momysnow/Momy-Desk-Robot/README.md

<div align="center">
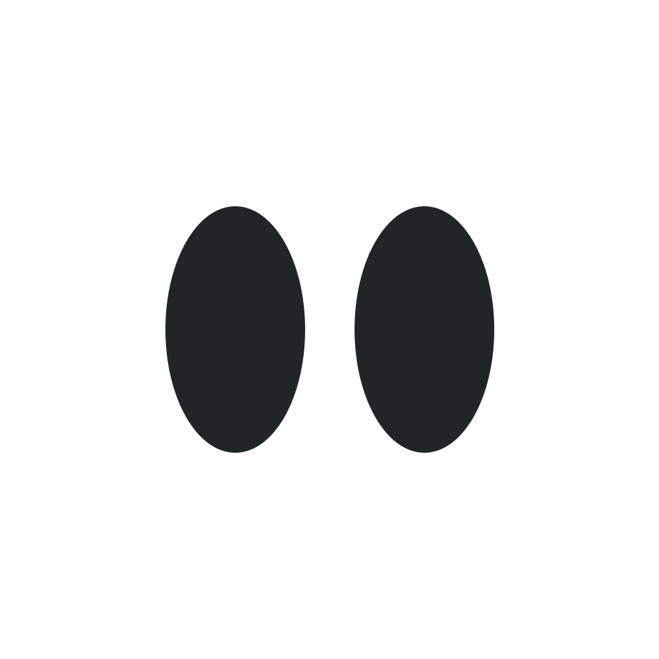
[picture p1: image/logo.png]
Momy logo
    
    <h1>Momy - Desk Robot</h1>
</div>

Welcome to the repository of the Momy project, a cutting-edge desk robot designed to provide a wide range of features that enhance human-machine interaction. Momy is equipped with advanced sensory and processing capabilities, making it an ideal companion for various daily activities.
<div align="center">
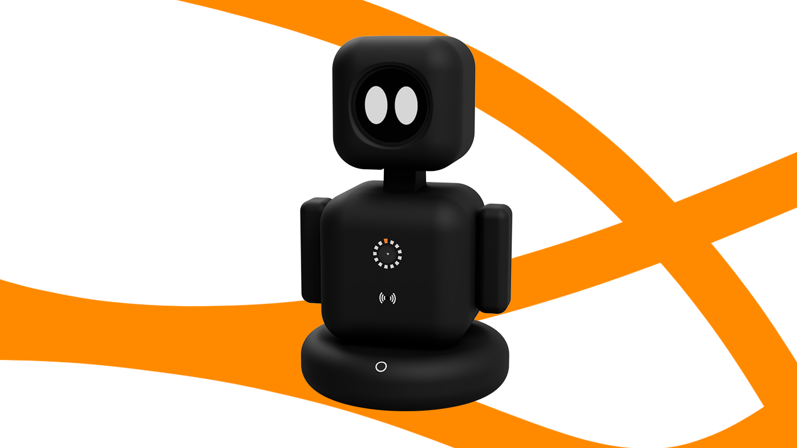
[picture p2: image/render_cubot_v5_sfondo.png]
Momy robot render
    
</div>

# Key Features
### 1. Advanced Vision
The integrated camera allows Momy to perceive and interpret the surrounding environment, opening the door to a range of applications, including facial recognition.

### 2. Active Listening
With the integrated microphone, Momy can listen and understand audio inputs. This feature not only enables vocal interaction with the robot but also opens the door to voice recognition applications.

### 3. Sound Response
The built-in speaker not only allows Momy to respond vocally but also provides the ability to produce a variety of sounds to enrich the interactive experience.

### 4. Visual Feedback
The built-in screen provides visual feedback to the user, allowing Momy to communicate effectively through text, graphics, and more.

### 5. Intelligent Mobility
Momy can move various parts of its body, ensuring a dynamic and interactive physical presence.

### 6. Environmental Monitoring
An integrated thermometer measures internal temperature and humidity, offering an additional dimension of environmental awareness and eliminating the possibility of damage caused by high temperatures or excessive humidity. In such cases, the robot enters protection mode and notifies the user of the issue.

### 7. Optimized Power System
Internal batteries enable Momy to operate wirelessly, with a recharge management module for added convenience.

### 8. Remote Control with ESP32S3
Using ESP32S3, Momy can be remotely controlled, browse the Internet, and handle complex tasks such as audio-to-text conversion.

<div align="center">
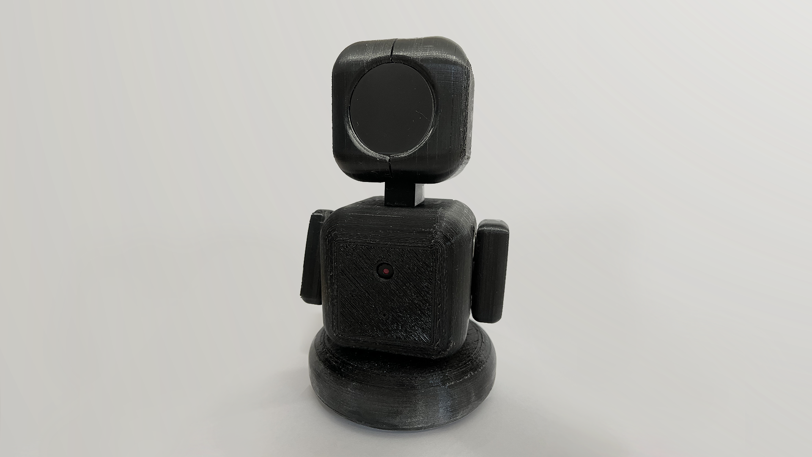
[picture p3: image/front_real.png]
Momy robot in reality
    
</div>

# Future Development Possibilities
The Momy project is open to further developments. Some possible extensions include integration with voice assistants like Alexa, sending camera images to a server for facial recognition, and many more.

# [Documentation and Instructions](https://github.com/momysnow/Momy-Desk-Robot/wiki)
For further details on configuration, installation, and use of Momy, refer to the Robot [Documentation](https://github.com/momysnow/Momy-Desk-Robot/wiki).

For detailed assembly and feature instructions, consult the Instruction Booklet(Coming Soon).

# [Discord Server](https://discord.gg/V63W7n23pe)
For easier communication and real-time updates on the project's progress, I have created a [Discord server](https://discord.gg/V63W7n23pe)!!

# Contributions
I'm excited to welcome contributions from the community! If you have ideas, suggestions, or wish to contribute to the development of Momy, feel free to join the community and propose your changes.

Thank you for exploring the Momy project with me. I'm excited to see how this versatile platform can enrich your daily experience!

I hope this presentation meets your needs. Feel free to customize it further based on the specific features and goals of your project.

# Copyright
<p xmlns:cc="http://creativecommons.org/ns#" xmlns:dct="http://purl.org/dc/terms/">All the files in <a property="dct:title" rel="cc:attributionURL" href="https://github.com/momysnow/Momy-Desk-Robot">Momy-Desk-Robot</a> by <a rel="cc:attributionURL dct:creator" property="cc:attributionName" href="https://github.com/momysnow">momysnow</a> is licensed under <a href="http://creativecommons.org/licenses/by-nc-sa/4.0/?ref=chooser-v1" target="_blank" rel="license noopener noreferrer" style="display:inline-block;">Attribution-NonCommercial-ShareAlike 4.0 International</a></p>
You can find a copy of the license in this repository.
