momysnow/Momy-Desk-Robot/image/components_img/Electronic/24-pin_0.5mm_FFC_FPC_Extender.jpg

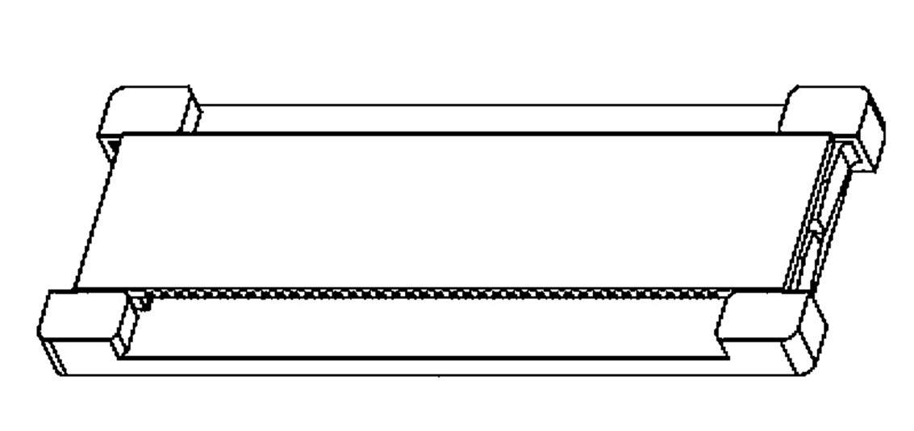
image/components_img/Electronic/24-pin_0.5mm_FFC_FPC_Extender.jpg
