momysnow/Momy-Desk-Robot/image/components_img/Electronic/DHT11.png

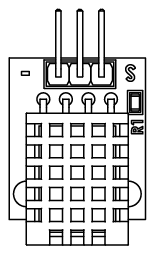
image/components_img/Electronic/DHT11.png
