momysnow/Momy-Desk-Robot/image/components_img/Electronic/Freenove_ESP32_S3_WROOM_Board.png

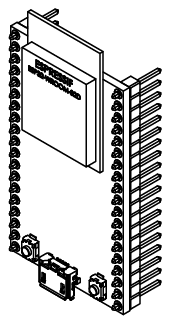
image/components_img/Electronic/Freenove_ESP32_S3_WROOM_Board.png
