momysnow/Momy-Desk-Robot/image/components_img/Electronic/inmp441.png

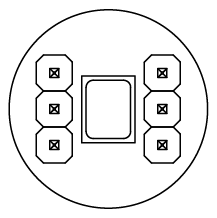
image/components_img/Electronic/inmp441.png
