momysnow/Momy-Desk-Robot/image/components_img/Electronic/Li-ion_18650.png

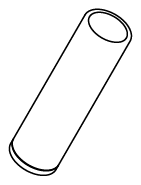
image/components_img/Electronic/Li-ion_18650.png
