momysnow/Momy-Desk-Robot/image/components_img/Electronic/MAX98357A.png

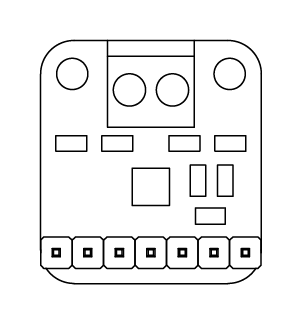
image/components_img/Electronic/MAX98357A.png
