momysnow/Momy-Desk-Robot/image/components_img/Electronic/ov2640.png

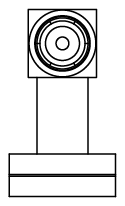
image/components_img/Electronic/ov2640.png
