momysnow/Momy-Desk-Robot/image/components_img/Electronic/Round_LCD_Display.png

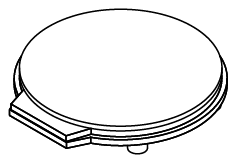
image/components_img/Electronic/Round_LCD_Display.png
