momysnow/Momy-Desk-Robot/image/components_img/Electronic/sg90-analog-9g.png

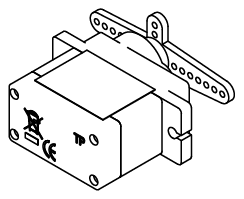
image/components_img/Electronic/sg90-analog-9g.png
