momysnow/Momy-Desk-Robot/image/components_img/Electronic/TP4056.png

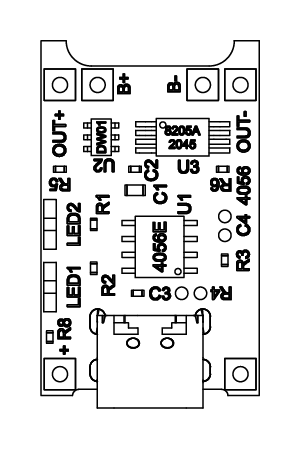
image/components_img/Electronic/TP4056.png
