momysnow/Momy-Desk-Robot/image/Momy.png

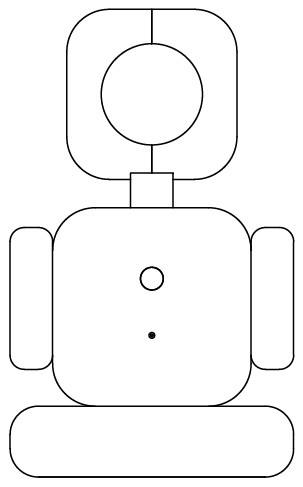
image/Momy.png
