momysnow/Momy-Desk-Robot/image/components_img/Physical/arm_L.jpg

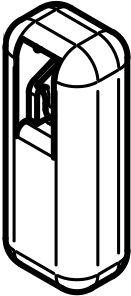
image/components_img/Physical/arm_L.jpg
