momysnow/Momy-Desk-Robot/image/components_img/Physical/arm_R.jpg

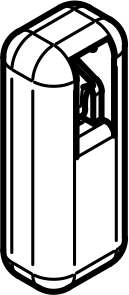
image/components_img/Physical/arm_R.jpg
