momysnow/Momy-Desk-Robot/image/components_img/Physical/back_body.jpg

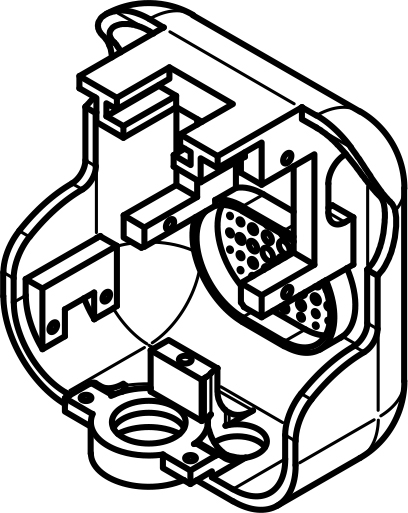
image/components_img/Physical/back_body.jpg
