momysnow/Momy-Desk-Robot/image/components_img/Physical/base.png

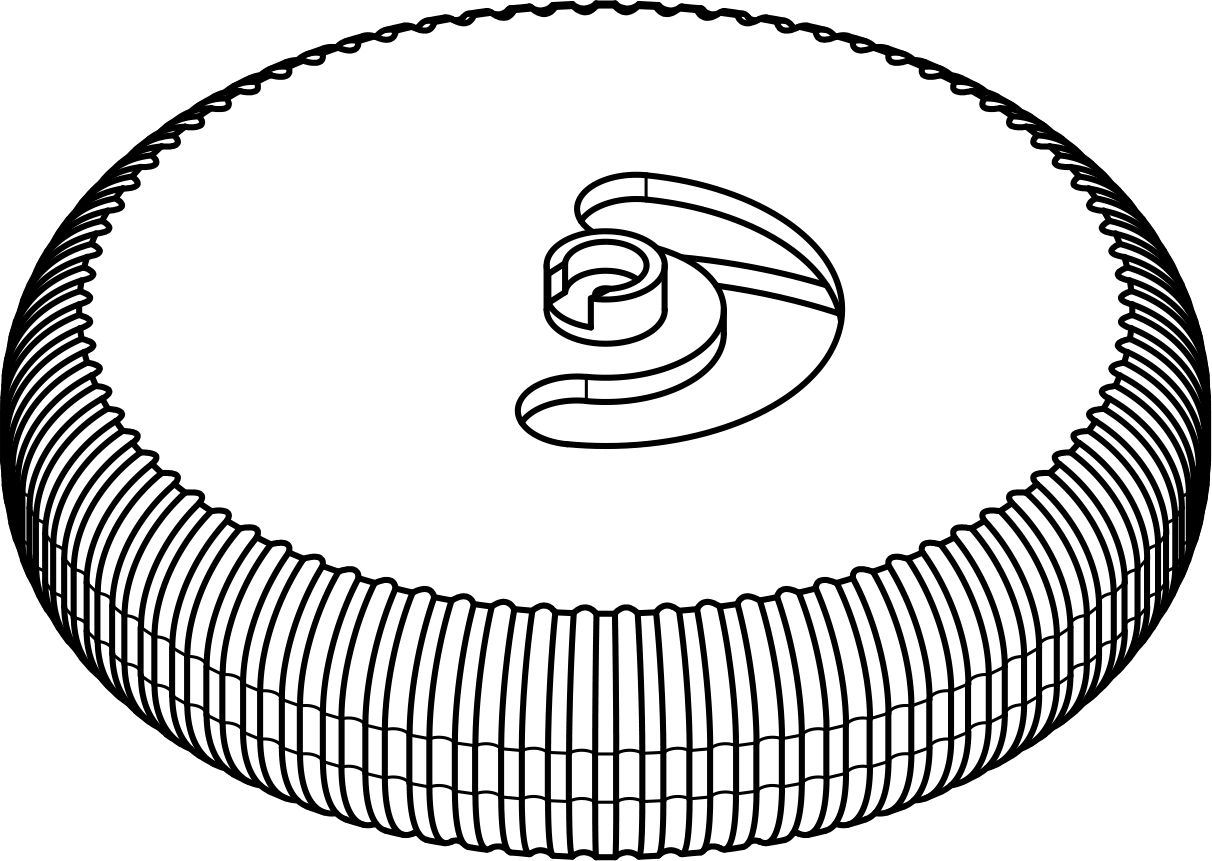
image/components_img/Physical/base.png
