momysnow/Momy-Desk-Robot/image/components_img/Physical/base_Rubber.jpg

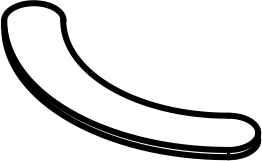
image/components_img/Physical/base_Rubber.jpg
