momysnow/Momy-Desk-Robot/image/components_img/Physical/bearing.png

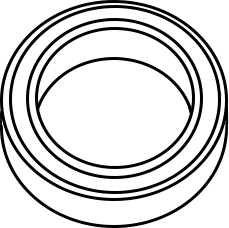
image/components_img/Physical/bearing.png
