momysnow/Momy-Desk-Robot/image/components_img/Physical/cover_base.jpg

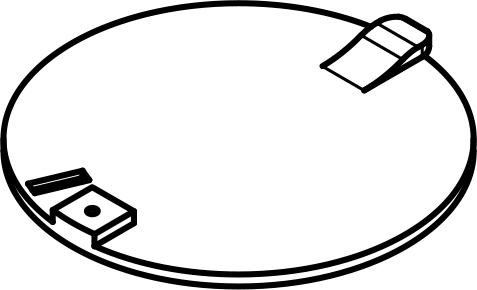
image/components_img/Physical/cover_base.jpg
