momysnow/Momy-Desk-Robot/image/components_img/Physical/front_body.jpg

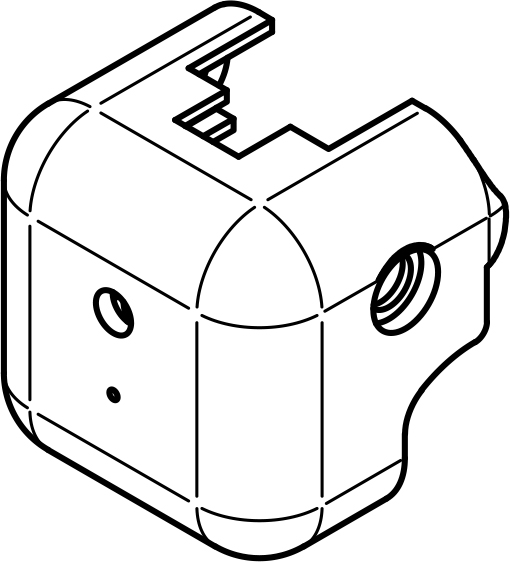
image/components_img/Physical/front_body.jpg
