momysnow/Momy-Desk-Robot/image/components_img/Physical/gear.png

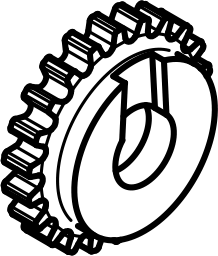
image/components_img/Physical/gear.png
