momysnow/Momy-Desk-Robot/image/components_img/Physical/head_L.jpg

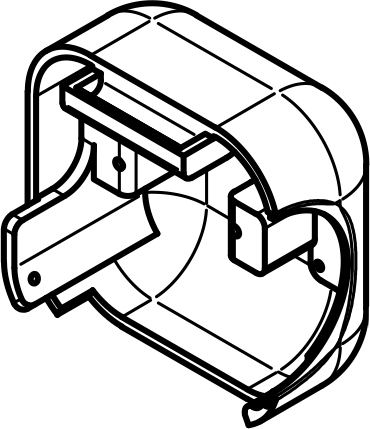
image/components_img/Physical/head_L.jpg
