momysnow/Momy-Desk-Robot/image/components_img/Physical/head_R.jpg

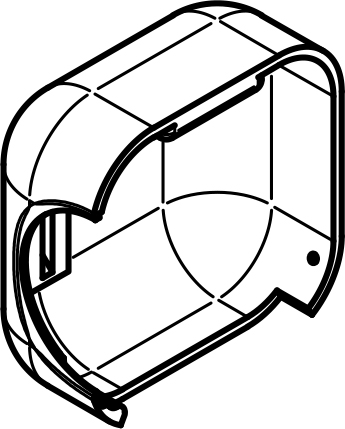
image/components_img/Physical/head_R.jpg
