momysnow/Momy-Desk-Robot/image/components_img/Physical/neck.png

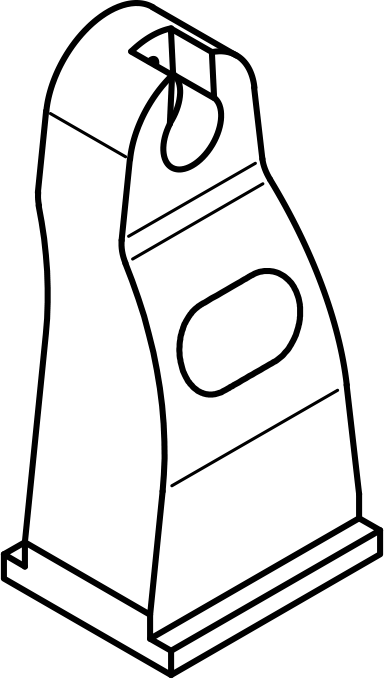
image/components_img/Physical/neck.png
