momysnow/Momy-Desk-Robot/image/components_img/Physical/original_screw_m2x8.png

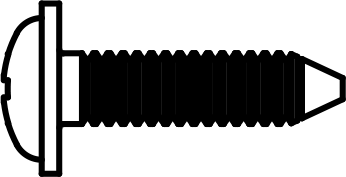
image/components_img/Physical/original_screw_m2x8.png
