momysnow/Momy-Desk-Robot/image/components_img/Physical/push_pin_L.png

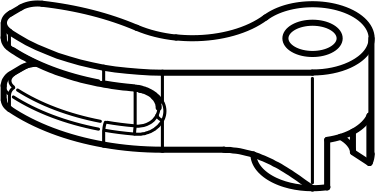
image/components_img/Physical/push_pin_L.png
