momysnow/Momy-Desk-Robot/image/components_img/Physical/push_pin_R.png

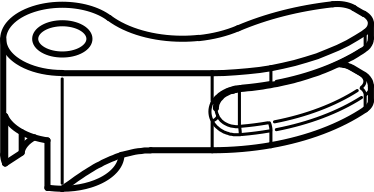
image/components_img/Physical/push_pin_R.png
