momysnow/Momy-Desk-Robot/image/components_img/Physical/rotate_arm.png

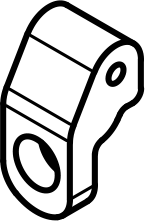
image/components_img/Physical/rotate_arm.png
