momysnow/Momy-Desk-Robot/image/components_img/Physical/rotate_gear.png

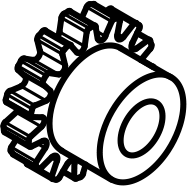
image/components_img/Physical/rotate_gear.png
