momysnow/Momy-Desk-Robot/image/components_img/Physical/screw.png

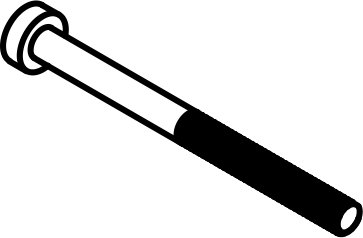
image/components_img/Physical/screw.png
