momysnow/Momy-Desk-Robot/image/components_img/Physical/screw_m2x4.png

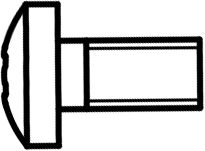
image/components_img/Physical/screw_m2x4.png
