momysnow/Momy-Desk-Robot/image/components_img/Physical/screw_m2x6.png

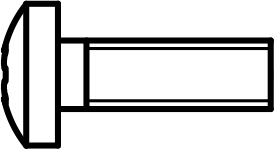
image/components_img/Physical/screw_m2x6.png
