momysnow/Momy-Desk-Robot/image/components_img/Physical/screw_m2x10.png

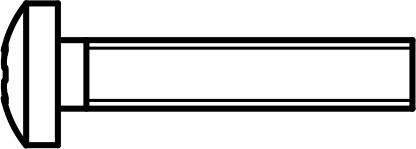
image/components_img/Physical/screw_m2x10.png
