momysnow/Momy-Desk-Robot/image/components_img/Physical/screw_m3x36.png

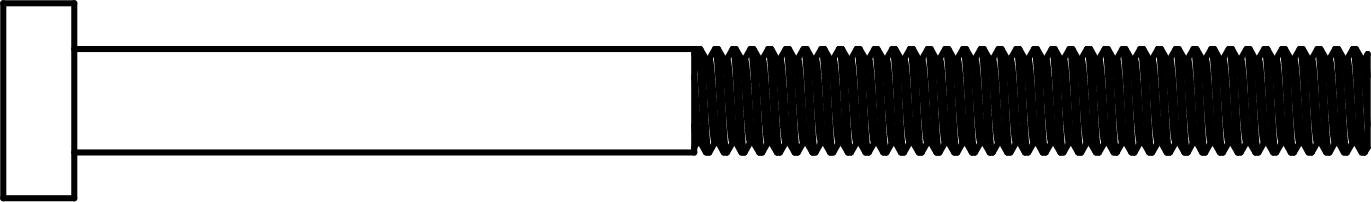
image/components_img/Physical/screw_m3x36.png
