momysnow/Momy-Desk-Robot/image/components_img/Physical/support.jpg

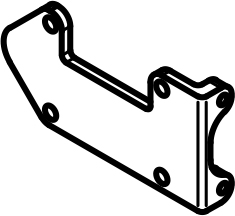
image/components_img/Physical/support.jpg
