momysnow/Momy-Desk-Robot/components/base/Base_Cap.stl

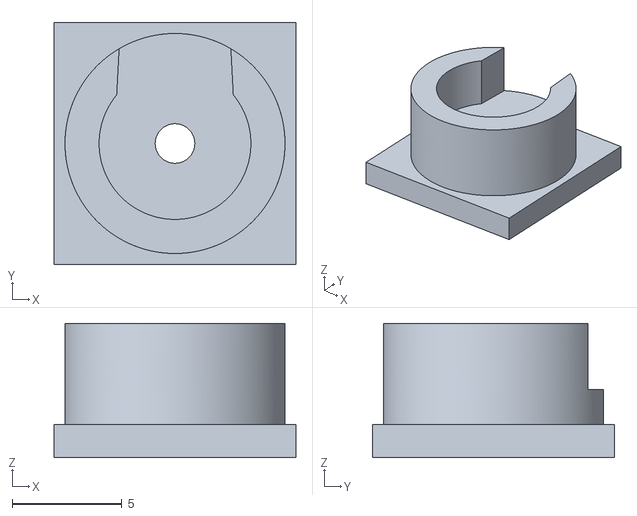
[picture p39: CAD file, 2024-02-13]
components/base/Base_Cap.stl
11.0 x 11.0 x 6.10
