momysnow/Momy-Desk-Robot/components/body/Body_Gear_Rotate_x2.stl

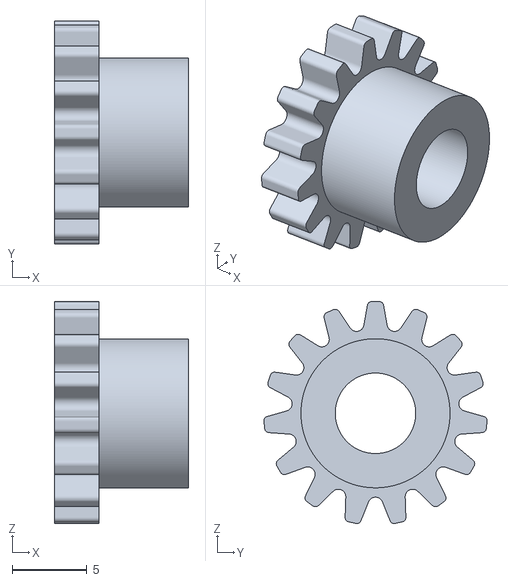
[picture p40: CAD file, 2024-02-10]
components/body/Body_Gear_Rotate_x2.stl
9.00 x 15.0 x 14.9
