momysnow/Momy-Desk-Robot/components/head/Head_Left.stl

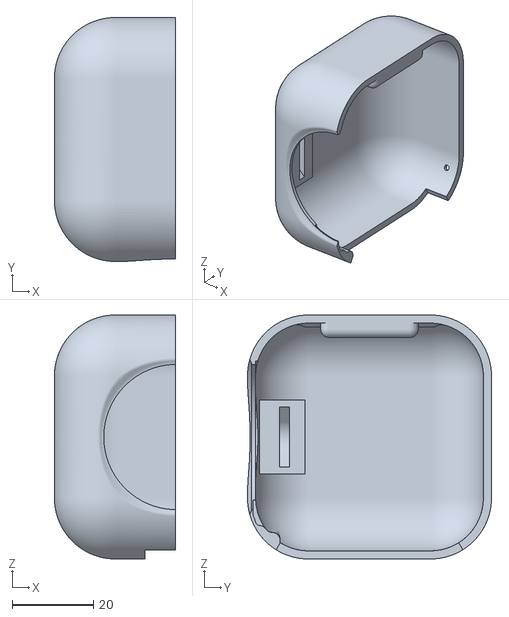
[picture p41: CAD file, 2024-02-10]
components/head/Head_Left.stl
29.8 x 60.0 x 60.0
