momysnow/Momy-Desk-Robot/components/Neck.stl

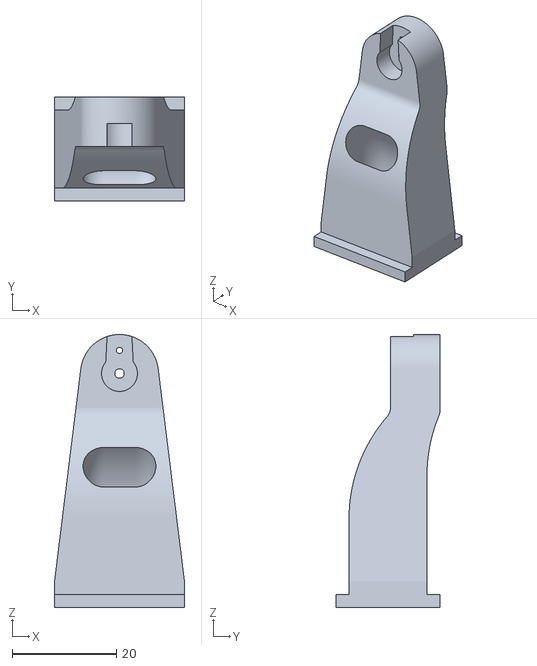
[picture p42: CAD file, 2024-02-10]
components/Neck.stl
25.0 x 20.0 x 52.5
