momysnow/Momy-Desk-Robot/components/base/Base_Bottom.stl

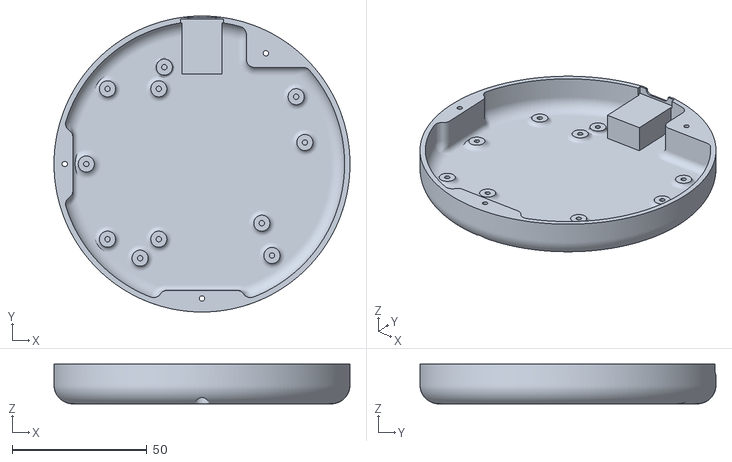
[picture p43: CAD file, 2024-02-13]
components/base/Base_Bottom.stl
110.0 x 110.0 x 14.8
