momysnow/Momy-Desk-Robot/components/body/Body_Gear_x2.stl

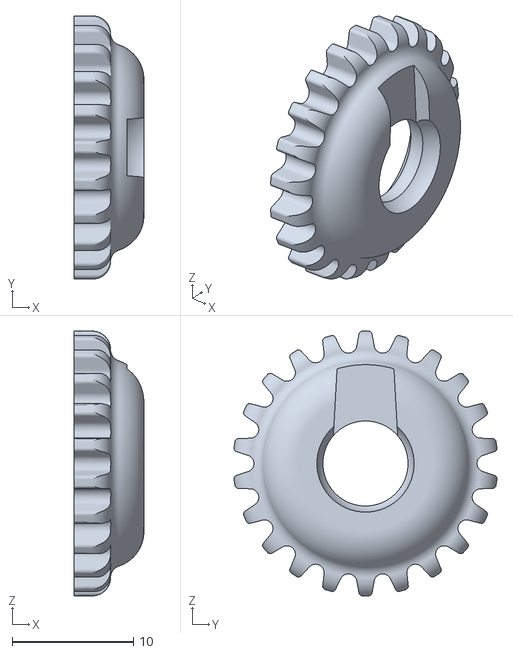
[picture p44: CAD file, 2024-02-10]
components/body/Body_Gear_x2.stl
5.75 x 21.7 x 21.8
