momysnow/Momy-Desk-Robot/components/head/Head_Right.stl

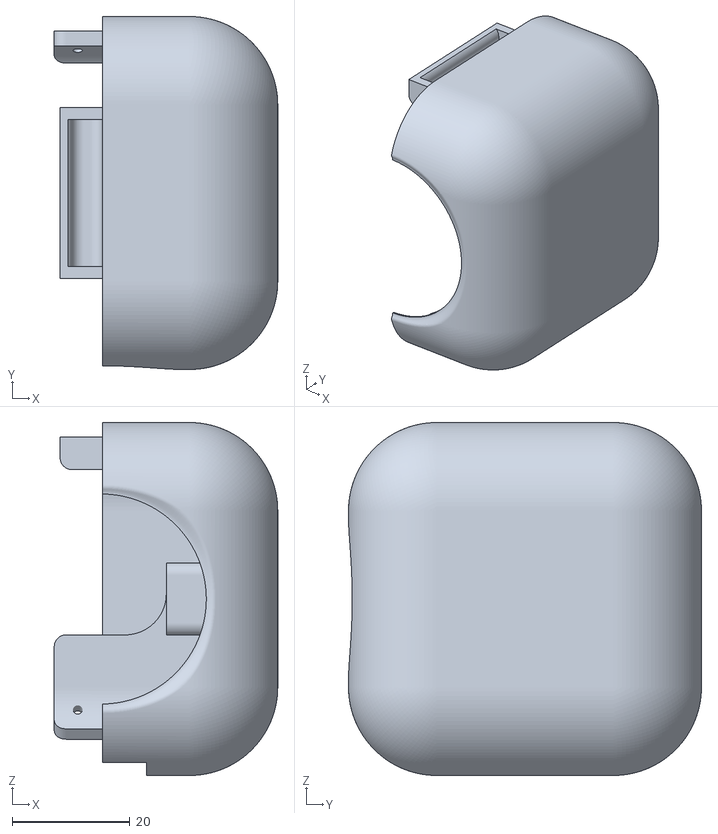
[picture p45: CAD file, 2024-02-10]
components/head/Head_Right.stl
38.0 x 60.0 x 60.0
