momysnow/Momy-Desk-Robot/components/body/Body_Rear.stl

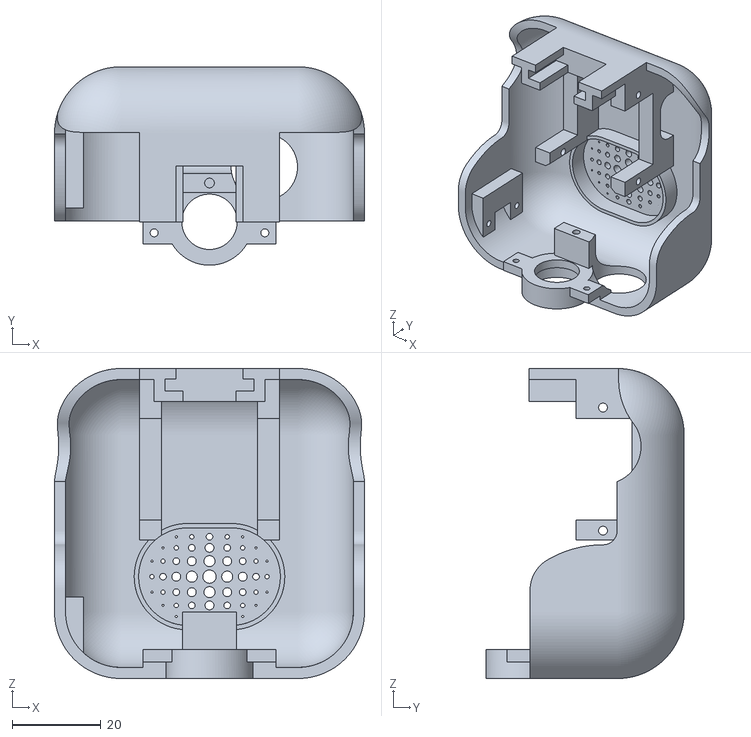
[picture p47: CAD file, 2024-02-04]
components/body/Body_Rear.stl
70.0 x 44.8 x 70.0
