momysnow/Momy-Desk-Robot/components/head/Head_Support.stl

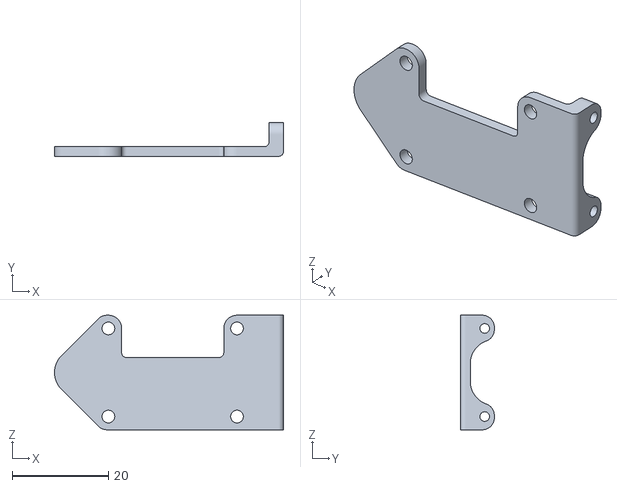
[picture p48: CAD file, 2024-02-04]
components/head/Head_Support.stl
47.5 x 7.00 x 23.8
