momysnow/Momy-Desk-Robot/components/base/Base_Rubber_Pad_x2.stl

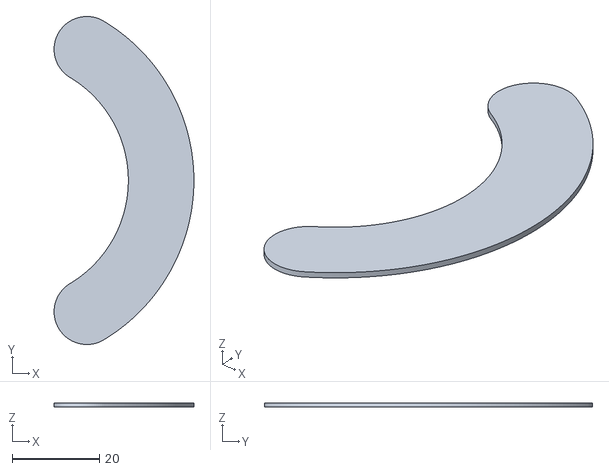
[picture p49: CAD file, 2024-02-04]
components/base/Base_Rubber_Pad_x2.stl
32.0 x 75.0 x 1.00
