momysnow/Momy-Desk-Robot/components/body/Body_Rotate_Arm_x2.stl

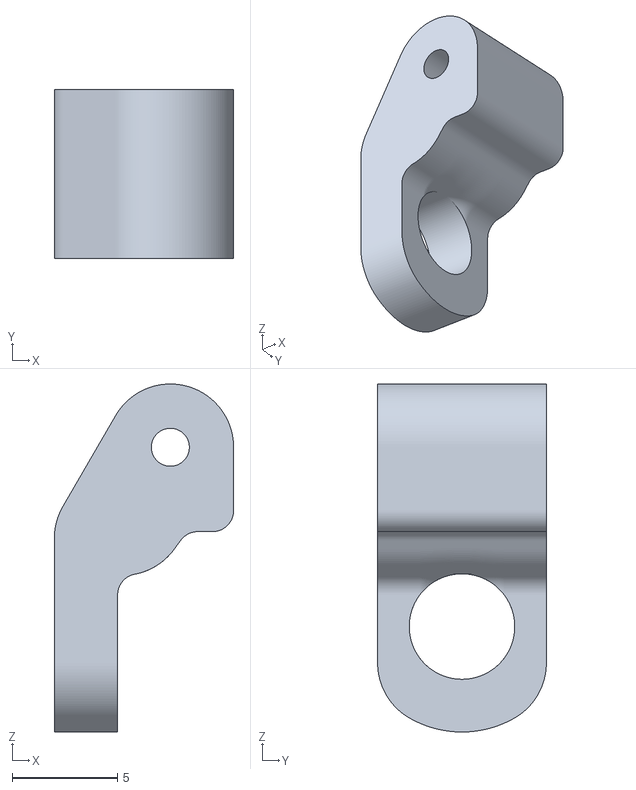
[picture p50: CAD file, 2024-02-04]
components/body/Body_Rotate_Arm_x2.stl
8.50 x 8.00 x 16.5
