momysnow/Momy-Desk-Robot/components/body/Body_Arm_Right.stl

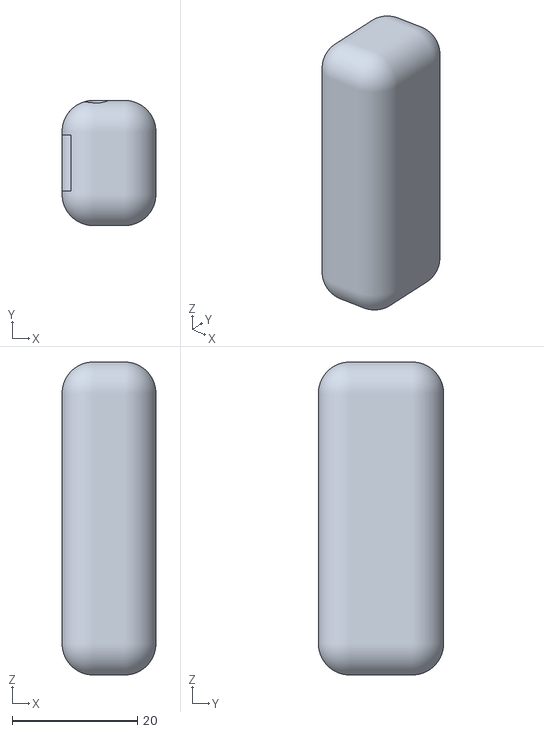
[picture p51: CAD file, 2024-02-04]
components/body/Body_Arm_Right.stl
15.0 x 20.0 x 50.0
