momysnow/Momy-Desk-Robot/components/body/Body_Ball_x2.stl

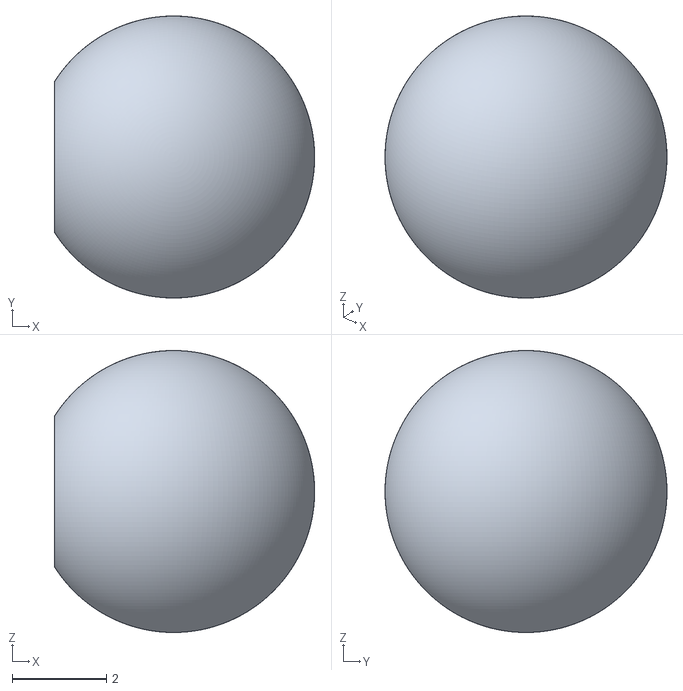
[picture p52: CAD file, 2024-02-04]
components/body/Body_Ball_x2.stl
5.54 x 6.00 x 6.00
