momysnow/Momy-Desk-Robot/components/body/Body_Push_Pin_Left.stl

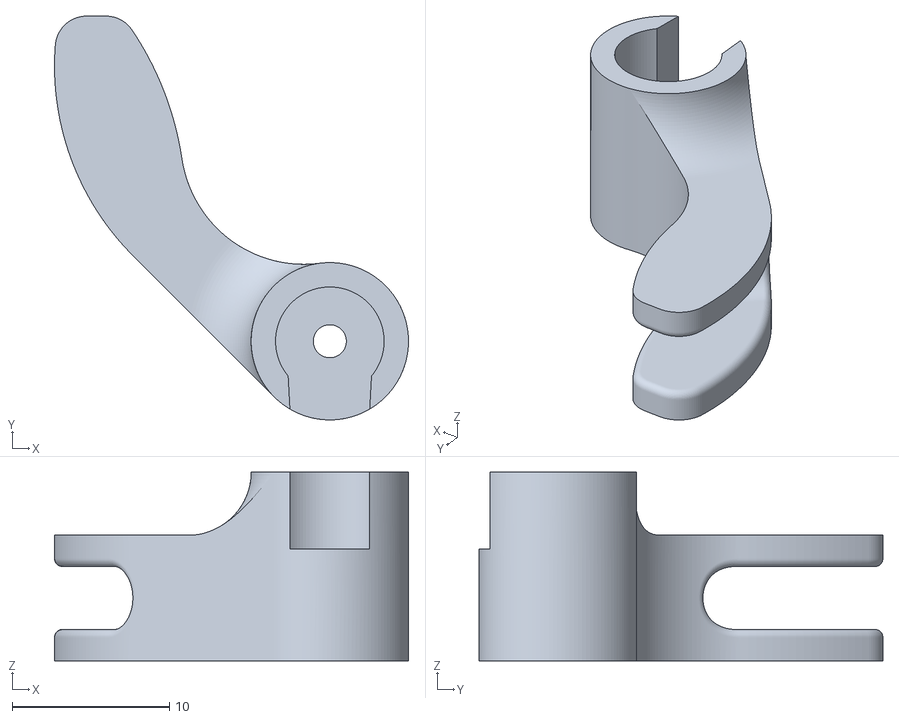
[picture p53: CAD file, 2024-02-04]
components/body/Body_Push_Pin_Left.stl
22.5 x 25.7 x 12.0
