momysnow/Momy-Desk-Robot/components/body/Body_Arm_Tube_x2.stl

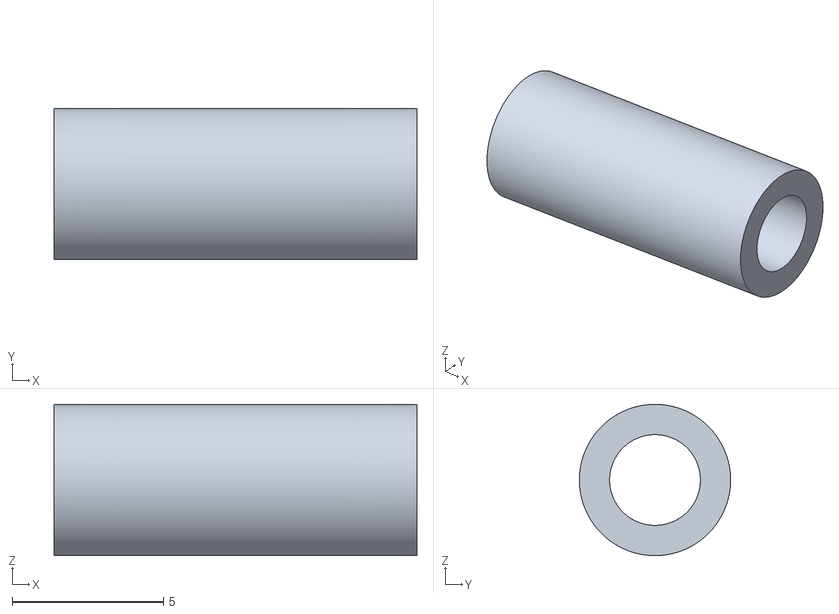
[picture p54: CAD file, 2024-02-04]
components/body/Body_Arm_Tube_x2.stl
12.0 x 5.00 x 5.00
