momysnow/Momy-Desk-Robot/components/body/Body_Anterior.stl

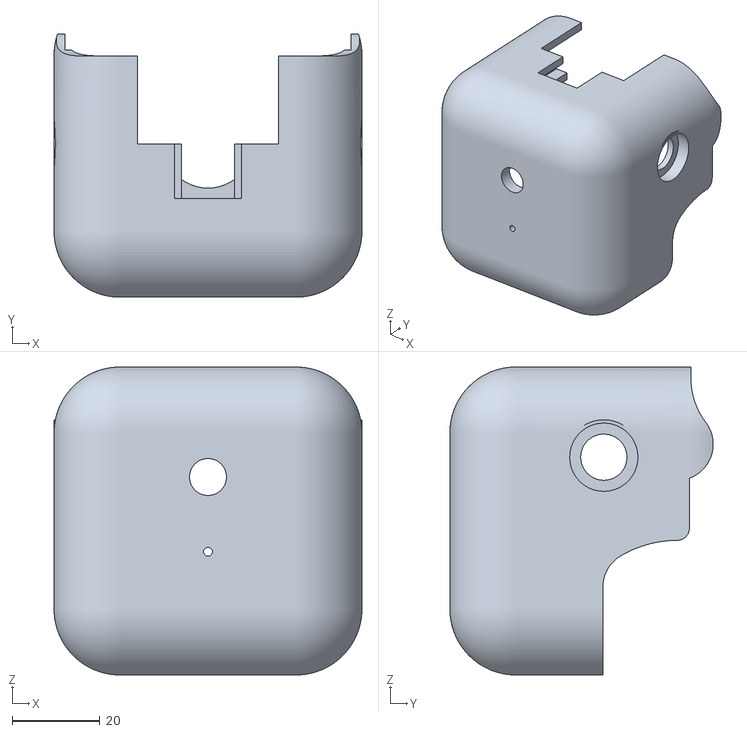
[picture p55: CAD file, 2024-02-04]
components/body/Body_Anterior.stl
70.0 x 59.9 x 70.0
