momysnow/Momy-Desk-Robot/(list of files, cad)

Other CAD files:
components/body/Body_Arm_Left.stl
components/body/Body_Push_Pin_Right.stl
components/body/Body_Closing_Screw_x2.stl
