momysnow/Momy-Desk-Robot/image/tutorial/arm.jpg

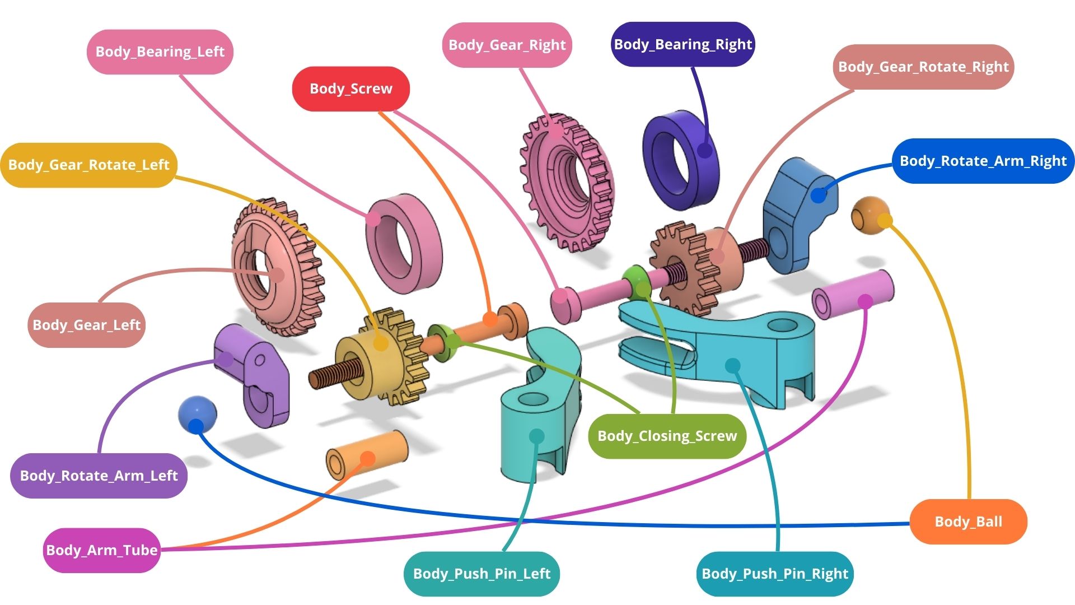
image/tutorial/arm.jpg
