momysnow/Momy-Desk-Robot/image/tutorial/base.jpg

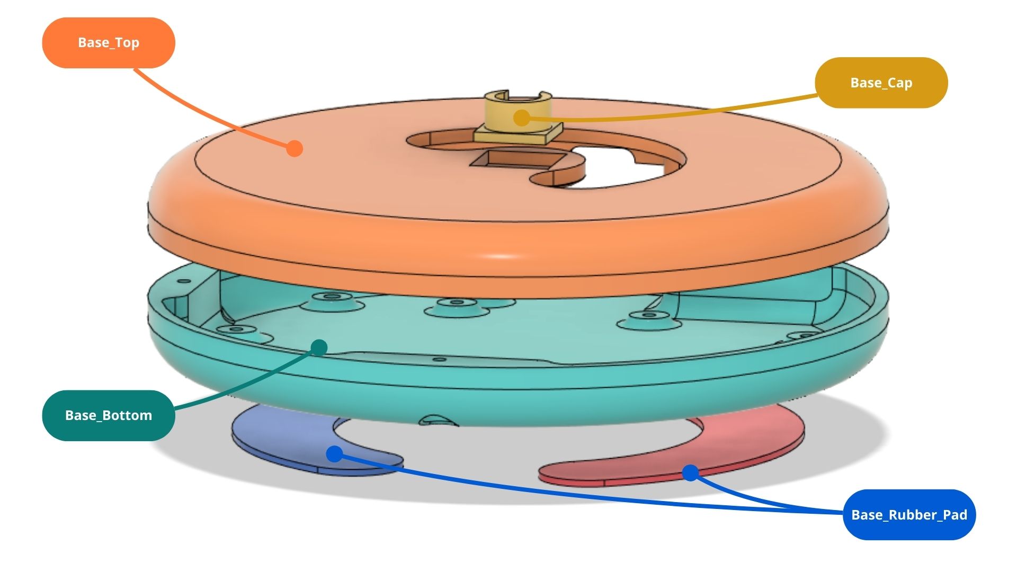
image/tutorial/base.jpg
