momysnow/Momy-Desk-Robot/image/tutorial/body.jpg

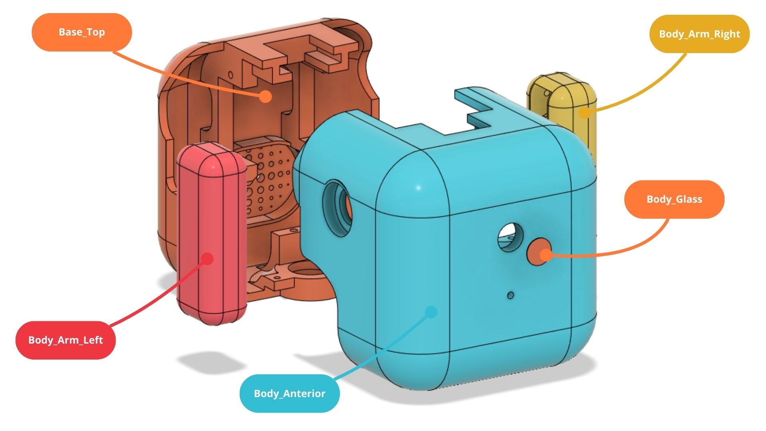
image/tutorial/body.jpg
