momysnow/Momy-Desk-Robot/image/tutorial/correct_screen.jpg

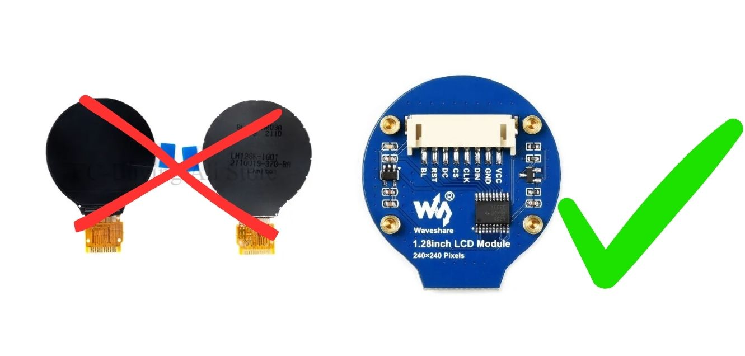
image/tutorial/correct_screen.jpg
