momysnow/Momy-Desk-Robot/image/tutorial/firmware/features.jpg

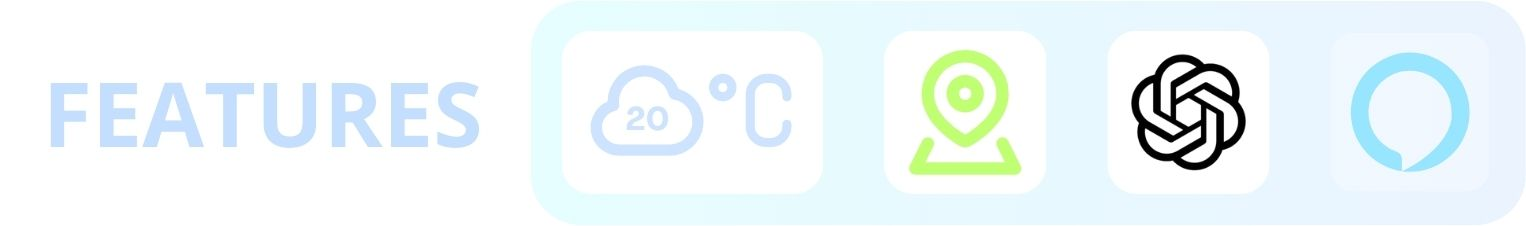
image/tutorial/firmware/features.jpg
