momysnow/Momy-Desk-Robot/image/tutorial/firmware/task.jpg

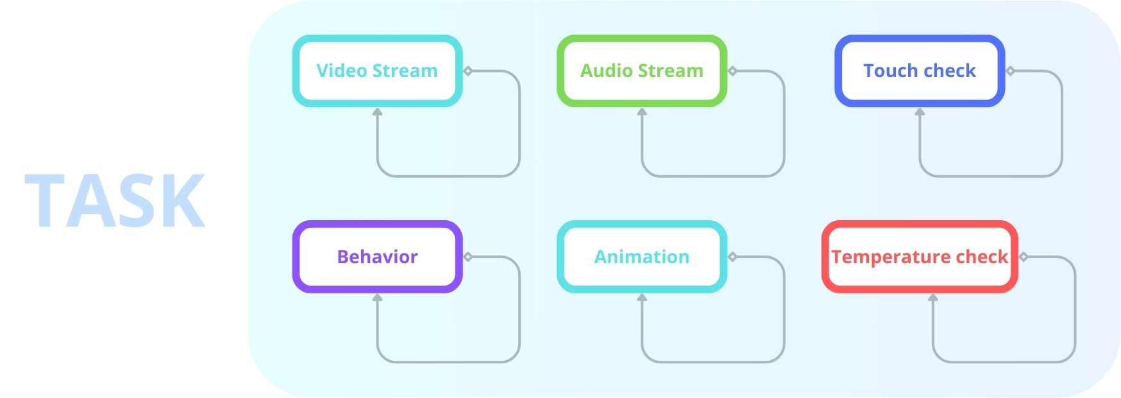
image/tutorial/firmware/task.jpg
