momysnow/Momy-Desk-Robot/image/tutorial/head.jpg

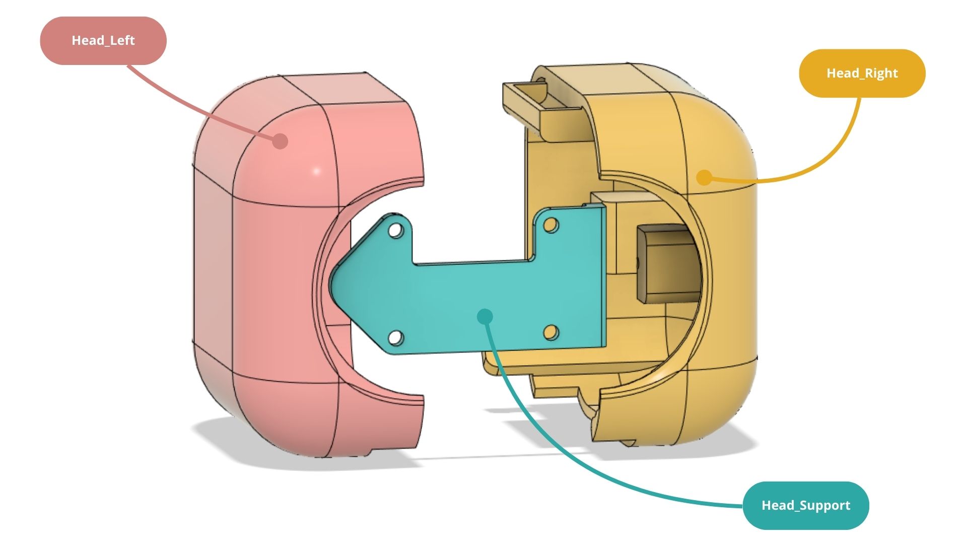
image/tutorial/head.jpg
