momysnow/Momy-Desk-Robot/image/tutorial/momyfull.jpg

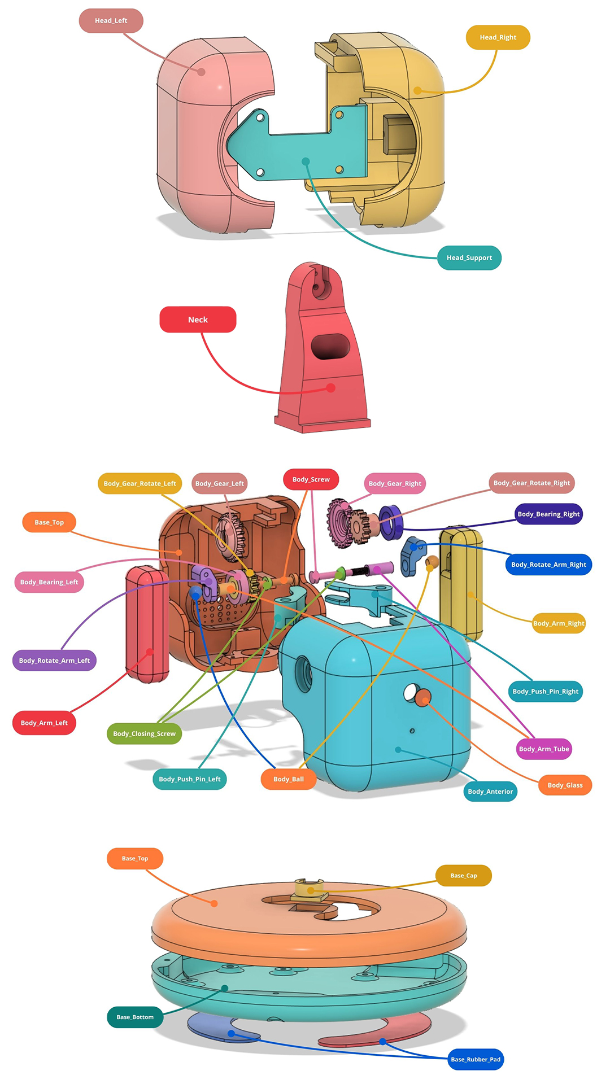
image/tutorial/momyfull.jpg
