momysnow/Momy-Desk-Robot/image/tutorial/neck.jpg

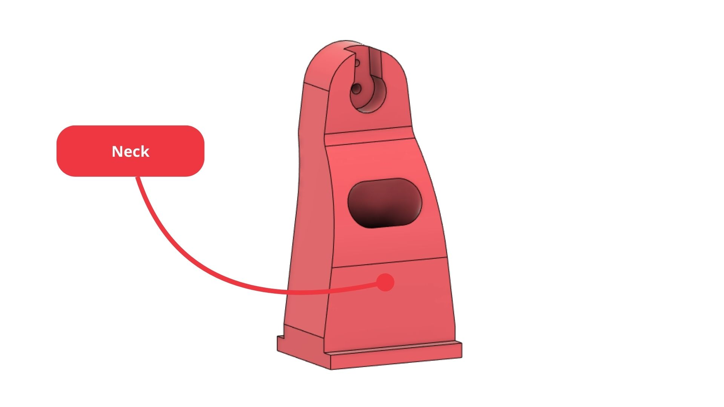
image/tutorial/neck.jpg
