momysnow/Momy-Desk-Robot/(threads)

Thread 1 (2023-12-03):

Bearing type in arms

chuismiguel, 2023-12-03:
Hello! I find your project super interesting and well done and I was looking forward to building your robot. I have seen in the step file that there is this piece

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

Who i understand is a bearing, since the arm rotates on it. It appears as "cuscinetto" who translates as bearing. Which type is it?

Thanks a lot in advance!

momysnow, 2023-12-03:
Hello, yes, it's a bearing. I forgot to translate the names in the STEP file as well. The bearings for the project are 6700ZZ, and I bought them on Amazon. Here is the link: [https://amzn.eu/d/4FSmGKP](https://amzn.eu/d/4FSmGKP). I looked for bearings that could work, but without delving too much into the specific features. If you find similar ones with the same dimensions, that's fine too.

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

Closed 2023-12-04.

Thread 2 (2024-01-05):

robot power supply

momysnow, 2024-01-05:
At the moment, I have not yet definitively decided on how to power the robot. To power all components simultaneously and under stress, considering possible additions of new components, we need 25W at 5V (thus 5V 5A). This poses some problems that need to be addressed.

In the market, it seems that there are no boards to power one's projects above 5V 2/3A that also manage battery charging and discharging. This leads us to choose between combining multiple components together, creating a mess, just to handle the entire power supply part (for example, using multiple tp4056 to reach the 25W in order to manage the batteries) or having to make custom boards, which do not fit the criteria decided for the robot's implementation, increasing the difficulty, costs, and availability.

Another problem not to be underestimated is the possible heat produced by the step-down to bring the current to 5V. The current choices are these, I already exclude removing the batteries from the base, even though it would drastically simplify things, because it seems that they are still of interest to many people.

I leave the link available for the temporary electrical schematic [here](https://www.canva.com/design/DAF3osjA1BU/6gnbjp2SR3YUcZbQxM9d_Q/edit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).

I hope someone can help me find a solution, thank you.

Closed 2024-02-10.

Thread 3 (2024-01-05):

change screen pin

momysnow, 2024-01-05:
The screen pins are the same as those of the SD card, so when both are used, they create problems. To solve this, I was thinking of simply moving the screen pins to something less frequently used to better manage the components, such as the DHT11, the touch sensor, and a less used servo (perhaps the one in the base). This way, if those components are being used, we won't use the SD, and vice versa.

Pin 38,39,40

momysnow, 2024-01-07:
New Pins
setup.h:
// DHT11
#define dhtPin 39

// touchPad
#define touchPadHeadPin 40

// Servo Motors
#define headServoPin 47
#define pushLServoPin 48
#define pushRServoPin 45
#define rotateLServoPin 0
#define rotateRServoPin 35
#define baseServoPin 38

User_Setup.h:
#define TFT_MOSI 42 // In some display driver board, it might be written as "SDA" and so on.
#define TFT_SCLK 41
#define TFT_CS   3  // Chip select control pin
#define TFT_DC   46  // Data Command control pin
#define TFT_RST  36  // Reset pin (could connect to Arduino RESET pin)
#define TFT_BL   37  // LED back-light

Closed 2024-01-07.

Thread 5 (2024-01-05):

Change servo object

momysnow, 2024-01-05:
The ESP32-S3 cannot handle more than 4 servos at a time, so we need to arrange and manage the servo objects efficiently to make multiple motors work simultaneously when needed.

An example of how to do this has been implemented by **Chuismiguel**:
```
void Movement::testServos(){
  controlServo_.attach(HEAD_SERVO_PIN, MIN_US, MAX_US);
  for (int pos = SERVO_LIMITS[HEAD_SERVO][0]; pos <= SERVO_LIMITS[HEADSERVO][1]; pos += 5) {
      controlServo.write(pos);
      delay(50);
  }
  for (int pos = SERVO_LIMITS[HEAD_SERVO][1]; pos >= SERVO_LIMITS[HEADSERVO][0]; pos -= 5) {
      controlServo.write(pos);
      delay(50);
  }
  controlServo_.write(RESTING_POSITIONS[HEADSERVO]);
  controlServo.detach();

  controlServo_.attach(BODY_SERVO_PIN, MIN_US, MAX_US);
  for (int pos = SERVO_LIMITS[BODY_SERVO][0]; pos <= SERVO_LIMITS[BODYSERVO][1]; pos += 5) {
      controlServo.write(pos);
      delay(50);
  }
  for (int pos = SERVO_LIMITS[BODY_SERVO][1]; pos >= SERVO_LIMITS[BODYSERVO][0]; pos -= 5) {
      controlServo.write(pos);
      delay(50);
  }
  controlServo_.write(RESTING_POSITIONS[BODYSERVO]);
  controlServo.detach();|
}
```

Closed 2024-02-13.

Thread 9 (2024-01-08):

Not enough pins

momysnow, 2024-01-08:
The management of the pins is getting complicated having to manage the various components to avoid conflicts of use, moreover other pins that I did not expect cannot be used because they are dedicated to specific functions of the ESP32

Thread 14 (2024-02-02):

Component names do not match STL files

hornetfighter515, 2024-02-02:
While it is a minor complaint, it would be nice if the component names listed in the [build documentation](https://github.com/momysnow/Momy-Desk-Robot/wiki/Build) were a 1:1 with the file names in the [components directory](https://github.com/momysnow/Momy-Desk-Robot/tree/main/components).

I would have made this PR myself, but it was evident to me that this would be a more complex task due to the compatibility with the [Fusion 360 file](https://github.com/momysnow/Momy-Desk-Robot/blob/main/components/Cubot_assembled_v3.f3z). I tried setting it up on my system and editing the Fusion 360 file myself, but quickly found I was out of my depth.

Additionally, it would be nice to have the part names on the build documentation be links to their corresponding STL files. If we want to break this portion into a separate task, I can handle it once the file part names are updated.

Finally, all parts should follow the same naming convention. To prevent confusion between Back and Bottom as B, and for consistency with this, we should have all relative directions have their full respective name. This will result in a naming scheme with capitalized letters separated by underscores followed by their verbose relative location, like Head_Left, or Push_Pin_Right

A full tasklist:
- For files:
  - [x] Rename [Body_L.stl](https://github.com/momysnow/Momy-Desk-Robot/blob/main/components/Head/Body_L.stl) to Head_Left.stl
  - [x] Rename [Body_R.stl](https://github.com/momysnow/Momy-Desk-Robot/blob/main/components/Head/Body_R.stl) to Head_Right.stl
  - [x] Rename [Anterior_body.stl](https://github.com/momysnow/Momy-Desk-Robot/blob/main/components/Body/Anterior_body.stl) to Body_Front.stl
  - [x] Rename [Body_rear.stl](https://github.com/momysnow/Momy-Desk-Robot/blob/main/components/Body/Rear_body.stl) to Body_Back.stl
  - [x] Rename [Arm.stl](https://github.com/momysnow/Momy-Desk-Robot/blob/main/components/Body/Arm.stl) to Arm_Left.stl
  - [x] Rename [Arm(mirrored).stl](https://github.com/momysnow/Momy-Desk-Robot/blob/main/components/Body/Arm(mirrored).stl) to Arm_Right.stl
  - [x] Rename [Push_pin.stl](https://github.com/momysnow/Momy-Desk-Robot/blob/main/components/Body/Push_pin.stl) to Push_Pin_L.stl
  - [x] Rename [Push_pin(mirrored).stl](https://github.com/momysnow/Momy-Desk-Robot/blob/main/components/Body/Push_pin(mirrored).stl) to Push_Pin_R.stl

- For documentation:
  - [x] Link components in the build file to their respective component files (for example, Head_Left should link to https://github.com/momysnow/Momy-Desk-Robot/blob/main/components/Head/Body_L.stl)
  - [x] Rename head_L to Head_Left
  - [x] Rename head_R to Head_Right
  - [x] Rename support to Support
  - [x] Rename neck to Neck
  - [x] Rename front_body to Body_Front
  - [x] Rename back_body to Body_Back
  - [x] Rename push_pin_L to Push_Pin_Left
  - [x] Rename push_pin_R to Push_Pin_Right
  - [x] Rename arm_L to Arm_Left
  - [x] Rename arm_R to Arm_Right
  - [x] Update all other names to use capital letters separated by underscores

hornetfighter515, 2024-02-07:
Instead of updating the existing diagrams, dev went a step further and made whole new diagrams. Marking as complete.

Closed 2024-02-07.

Thread 15 (2024-02-21):

Increase divot inside head so it lines up

hornetfighter515, 2024-02-21:
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

When the robot's head is closed, the pieces do not line up because the divot inside the side of the head that the screen is not attached to is too shallow to allow the screen brace to slide in. One solution to this would be to increase the depth of the divot.

Alternatively, the head could be split along a different plane in an irregular pattern more similar to the body, where the pieces are front and back instead of left and right. This may be more aesthetically pleasing and prevent breaking the screen and lining up the brace from being as big of a concern.

Thread 16 (2024-02-21):

TFT_eSPI User_Setup.h  is not included as advised in the TFT_eSPI documentation

hornetfighter515, 2024-02-21:
https://github.com/Bodmer/TFT_eSPI?tab=readme-ov-file#tips says that we should have the file in a separate directory and import it.

```
Tips

If you load a new copy of TFT_eSPI then it will overwrite your setups if they are kept within the TFT_eSPI folder. One way around this is to create a new folder in your Arduino library folder called "TFT_eSPI_Setups". You then place your custom setup.h files in there. After an upgrade simply edit the User_Setup_Select.h file to point to your custom setup file e.g.:

#include <../TFT_eSPI_Setups/my_custom_setup.h>

You must make sure only one setup file is called. In the custom setup file I add the file path as a commented out first line that can be cut and pasted back into the upgraded User_Setup_Select.h file. The ../ at the start of the path means go up one directory level. Clearly you could use different file paths or directory names as long as it does not clash with another library or folder name.

You can take this one step further and have your own setup select file and then you only need to replace the Setup.h line reference in User_Setup_Select.h to, for example:

#include <../TFT_eSPI_Setups/my_setup_select.h>

To select a new setup you then edit your own my_setup_select.h file (which will not get overwritten during an upgrade).
```
