momysnow/Momy-Desk-Robot/utilities_code/setup/setup.h

// setup.h
#ifndef SETUP_H
#define SETUP_H

// touchPad
#define touchPadHeadPin 2

// Servo Motors
#define headServoPin 47
#define pushLServoPin 48
#define pushRServoPin 45
#define rotateLServoPin 11
#define rotateRServoPin 35
#define baseServoPin 38

#endif
