momysnow/Momy-Desk-Robot/boot/CameraUploader.cpp

#include "CameraUploader.h"
#include "camera_pins.h"

CameraUploader::CameraUploader(const char* serverIp, int serverPort)
  : serverIp(serverIp), serverPort(serverPort) {}

void CameraUploader::begin() {
  Serial.begin(115200);
  Serial.println();

  WiFiManager wifiManager;
  wifiManager.autoConnect("AutoConnectAP");

  cameraSetup();

  Serial.println("WiFi connected");
}

void CameraUploader::uploadImage() {
  if (client.connected()) {
    Serial.println("Connected to server");

    camera_fb_t* fb = esp_camera_fb_get();
    if (fb) {
      Serial.print("Sending image to server... ");

      uint8_t slen[4];
      slen[0] = fb->len >> 0;
      slen[1] = fb->len >> 8;
      slen[2] = fb->len >> 16;
      slen[3] = fb->len >> 24;

      client.write(slen, 4);
      client.write(fb->buf, fb->len);

      esp_camera_fb_return(fb);

      Serial.println("Image sent");
    } else {
      Serial.println("Error capturing image from camera");
    }
  } else {
    Serial.println("Connection lost. Reconnecting...");
    client.connect(serverIp, serverPort);
  }

  delay(30);  // Interval between image uploads
}

void CameraUploader::cameraSetup() {
  camera_config_t config;
  config.ledc_channel = LEDC_CHANNEL_0;
  config.ledc_timer = LEDC_TIMER_0;
  config.pin_d0 = Y2_GPIO_NUM;
  config.pin_d1 = Y3_GPIO_NUM;
  config.pin_d2 = Y4_GPIO_NUM;
  config.pin_d3 = Y5_GPIO_NUM;
  config.pin_d4 = Y6_GPIO_NUM;
  config.pin_d5 = Y7_GPIO_NUM;
  config.pin_d6 = Y8_GPIO_NUM;
  config.pin_d7 = Y9_GPIO_NUM;
  config.pin_xclk = XCLK_GPIO_NUM;
  config.pin_pclk = PCLK_GPIO_NUM;
  config.pin_vsync = VSYNC_GPIO_NUM;
  config.pin_href = HREF_GPIO_NUM;
  config.pin_sscb_sda = SIOD_GPIO_NUM;
  config.pin_sscb_scl = SIOC_GPIO_NUM;
  config.pin_pwdn = PWDN_GPIO_NUM;
  config.pin_reset = RESET_GPIO_NUM;
  config.xclk_freq_hz = 20000000;
  config.frame_size = FRAMESIZE_HVGA;
  config.pixel_format = PIXFORMAT_JPEG;  // for streaming
  config.grab_mode = CAMERA_GRAB_WHEN_EMPTY;
  config.fb_location = CAMERA_FB_IN_PSRAM;
  config.jpeg_quality = 10;
  config.fb_count = 1;

  // if PSRAM IC present, init with UXGA resolution and higher JPEG quality
  // for larger pre-allocated frame buffer.
  if (psramFound()) {
    config.jpeg_quality = 10;
    config.fb_count = 2;
    config.grab_mode = CAMERA_GRAB_LATEST;
  } else {
    // Limit the frame size when PSRAM is not available
    config.frame_size = FRAMESIZE_CIF;
    config.fb_location = CAMERA_FB_IN_DRAM;
  }

  // camera init
  esp_err_t err = esp_camera_init(&config);
  if (err != ESP_OK) {
    Serial.printf("Camera init failed with error 0x%x", err);
    return;
  }

  sensor_t* s = esp_camera_sensor_get();
  // initial sensors are flipped vertically and colors are a bit saturated
  s->set_brightness(s, 0);                  // -2 to 2
  s->set_contrast(s, 0);                    // -2 to 2
  s->set_saturation(s, 0);                  // -2 to 2
  s->set_special_effect(s, 0);              // 0 to 6 (0 - No Effect, 1 - Negative, 2 - Grayscale, 3 - Red Tint, 4 - Green Tint, 5 - Blue Tint, 6 - Sepia)
  s->set_whitebal(s, 1);                    // 0 = disable , 1 = enable
  s->set_awb_gain(s, 1);                    // 0 = disable , 1 = enable
  s->set_wb_mode(s, 0);                     // 0 to 4 - if awb_gain enabled (0 - Auto, 1 - Sunny, 2 - Cloudy, 3 - Office, 4 - Home)
  s->set_exposure_ctrl(s, 1);               // 0 = disable , 1 = enable
  s->set_aec2(s, 0);                        // 0 = disable , 1 = enable
  s->set_ae_level(s, 0);                    // -2 to 2
  s->set_aec_value(s, 300);                 // 0 to 1200
  s->set_gain_ctrl(s, 1);                   // 0 = disable , 1 = enable
  s->set_agc_gain(s, 0);                    // 0 to 30
  s->set_gainceiling(s, (gainceiling_t)0);  // 0 to 6
  s->set_bpc(s, 0);                         // 0 = disable , 1 = enable
  s->set_wpc(s, 1);                         // 0 = disable , 1 = enable
  s->set_raw_gma(s, 1);                     // 0 = disable , 1 = enable
  s->set_lenc(s, 1);                        // 0 = disable , 1 = enable
  s->set_hmirror(s, 0);                     // 0 = disable , 1 = enable
  s->set_vflip(s, 0);                       // 0 = disable , 1 = enable
  s->set_dcw(s, 1);                         // 0 = disable , 1 = enable
  s->set_colorbar(s, 0);                    // 0 = disable , 1 = enable

  Serial.println("Camera configuration complete!");
}
