momysnow/Momy-Desk-Robot/(commit log)

2023-11-27 Robot components file
    [Arm.stl, Back_body.stl, Body_L.stl, Body_R.stl, Closing_screw.stl, Cover.stl, Extender.stl, Front_body.stl]
2023-12-17 add new version
    [Anterior_body.stl, Arm(mirrored).stl, Arm.stl, Ball.stl, Base_cap.stl, Body_L.stl, Body_R.stl, Closing_screw.stl]
2023-12-27 Update boot.ino
    added, mqtt, simple timer and arduino ota
2024-02-22 Update initialization, extract display tools, move camera initialization
